ErmanIZTECH/RF_data_transmitter_and_receiver/Circuit.asc

6u: ind; 4.6µ
B1: bv; V=V(Ut)*0.02
C1: cap; 591p
C2: cap; .01µ
C3: cap; 1n
C4: cap; 100n
C5: cap; 1n
C6: cap; 1n
C7: cap; 0.1n
C8: cap; .01µ
C9: cap; .1µ
C10: cap; 10µ
C15: cap; .1µ
C18: cap; 1n
C19: cap; 10n
C20: cap; 100n
C24: cap; 1n
Cci1: cap; 47µ
Cci2: cap; 100n
Cci3: cap; 47p
Cci4: cap; 100n
CE1: cap; 100n
CE2: cap; 100n
CE3: cap; 100n
D1: diode; MMSD4148
L1: ind; 50µ
L2: ind; 4.6µ
L3: ind; 4.6µ
L6: ind; 4.6µ
Q1: npn; BC237
Q2: npn; 2N2222
Q3: npn; 2N2222
Q4: npn; BC547B
Q10: npn; BC237
Q11: npn; BC237
Q13: npn; BC547B
R1: res; 100k
R2: res; 5.6k
R3: res; 30k
R4: res; 3k
R5: res; 1.5k
R6: res; 25k
R7: res; 45k
R8: res; 5.6k
R9: res; 5.6k
R10: res; 100k
R11: RES; 48k
R12: res; 1k
R13: res; 220
R14: RES; 5k
R15: res; 10k
R16: res; 100k
R17: res; 10k
R18: res; 10k
R19: res; 400
R35: RES; 48k
R36: RES; 5k
R38: RES; 3.3k
R39: RES; 5.4k
R41: res; 2k
R43: res; 100k
R44: RES; 48k
R45: RES; 5k
RC1: res; 1.5k
RC2: res; 50
RC3: res; 1.5k
RC4: res; 1.5k
RE1: res; 100
RE2: res; 100
RE3: res; 100
RE5: res; 100
U1: LM108A
V1: voltage; 5v
V3: signal; PULSE(0 5 0 5u 5u 0.052m .104m); AC 1 0
V4: voltage; 5v
VCC3: voltage; 12v
Named nets: 0, Ct, Ut, Vcc, Mt, 12v, 5v, RS232
.tran 300u
Amplitude Modulator
Colpitts Oscillator
Buffer
.step param X 0.01m 0.100m 0.01m
.MODEL BC237 NPN (
+IS =1.8E-14 ISE=5.0E-14 NF =.9955 NE =1.46 BF =400
+BR =35.5 IKF=.14 IKR=.03 ISC=1.72E-13 NC =1.27 NR =1.005 RB =.56 RE =.6
+RC =.25 VAF=80 VAR=12.5 CJE=13E-12 TF =.64E-9 CJC=4E-12 TR =50.72E-9
+VJC=.54 MJC=.33 )
.MODEL BC327 PNP (IS=10.0029F BF=402.001 NF=994.875M VAF=100 IKF=991.671M
+ ISE=1.218485E-022 NE=2.14585 BR=101.214M IKR=1.00622 ISC=1.218700E-019
+ RE=360.928M RC=743.15M CJE=2P MJE=500M CJC=50.3851P VJC=700M MJC=558.066M
+ TF=501.007P XTF=499.987M VTF=10 ITF=10.0724M TR=10N )
Attenuated Signal
Channel Representation
Receiver Tuned Amp.
Envelope Detector
Rx Antenna
Transmitter Tuned Amplifier
Tx Antenna
Channel
Schmitt Trigger
